dewhisna/TB6600StepperDriver/README.md

# TB6600StepperDriver

This repository contains custom TB6600 Stepper Motor Driver Designs.  It specifically targets retrofit replacement designs for the common HY-DIV268N module.
