dewhisna/TB6600StepperDriver/DEW_TB6600-V1/README.md

# Dewtronics TB6600 Stepper Driver Board V1 (DEW_TB6600-V1)

A much improved drop-in replacement for the common TB6600/HY-DIV268N Stepper Driver Module.

This board can be ordered from [https://www.oshpark.com/shared_projects/tKN4X7AL](https://www.oshpark.com/shared_projects/tKN4X7AL).

A customizable 3D Printable case can be found at: [https://www.thingiverse.com/thing:1917535](https://www.thingiverse.com/thing:1917535).
