dewhisna/TB6600StepperDriver/DEW_TB6600-V1/preview/DEW_TB6600-V1-00b-BoardBottom.png

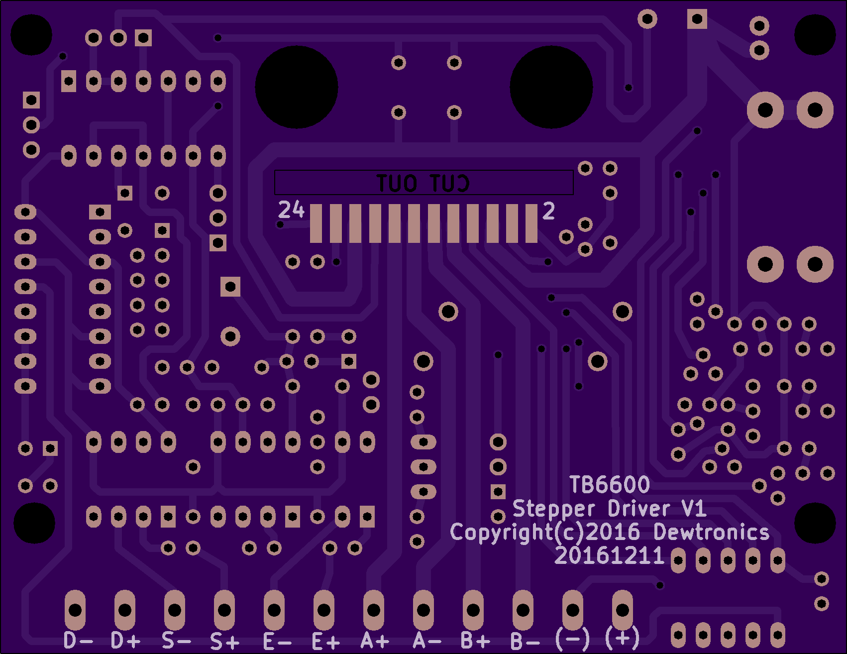
DEW_TB6600-V1/preview/DEW_TB6600-V1-00b-BoardBottom.png
