dewhisna/TB6600StepperDriver/DEW_TB6600-V1/preview/DEW_TB6600-V1-03-Drills.png

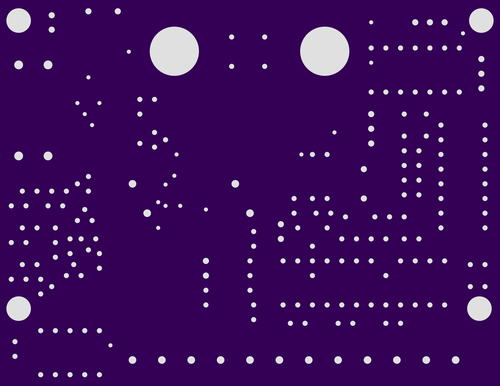
DEW_TB6600-V1/preview/DEW_TB6600-V1-03-Drills.png
