dewhisna/TB6600StepperDriver/DEW_TB6600-V1/preview/DEW_TB6600-V1-05-BottomLayer.png

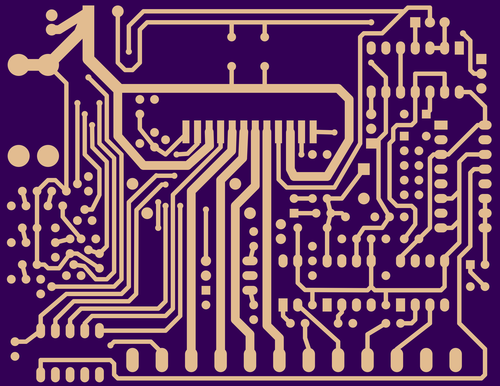
DEW_TB6600-V1/preview/DEW_TB6600-V1-05-BottomLayer.png
