dewhisna/TB6600StepperDriver/DEW_TB6600-V1/preview/DEW_TB6600-V1-09-BottomSilkScreen.png

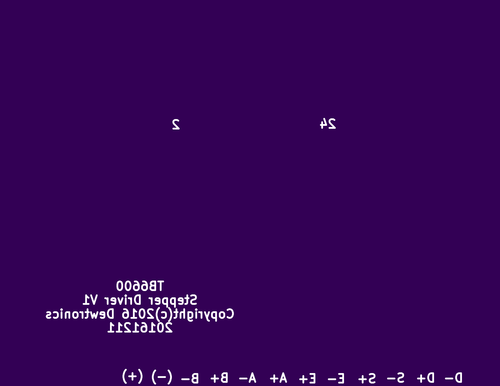
DEW_TB6600-V1/preview/DEW_TB6600-V1-09-BottomSilkScreen.png
