dewhisna/TB6600StepperDriver/DEW_TB6600-V1/DEW_TB6600-V1.pdf

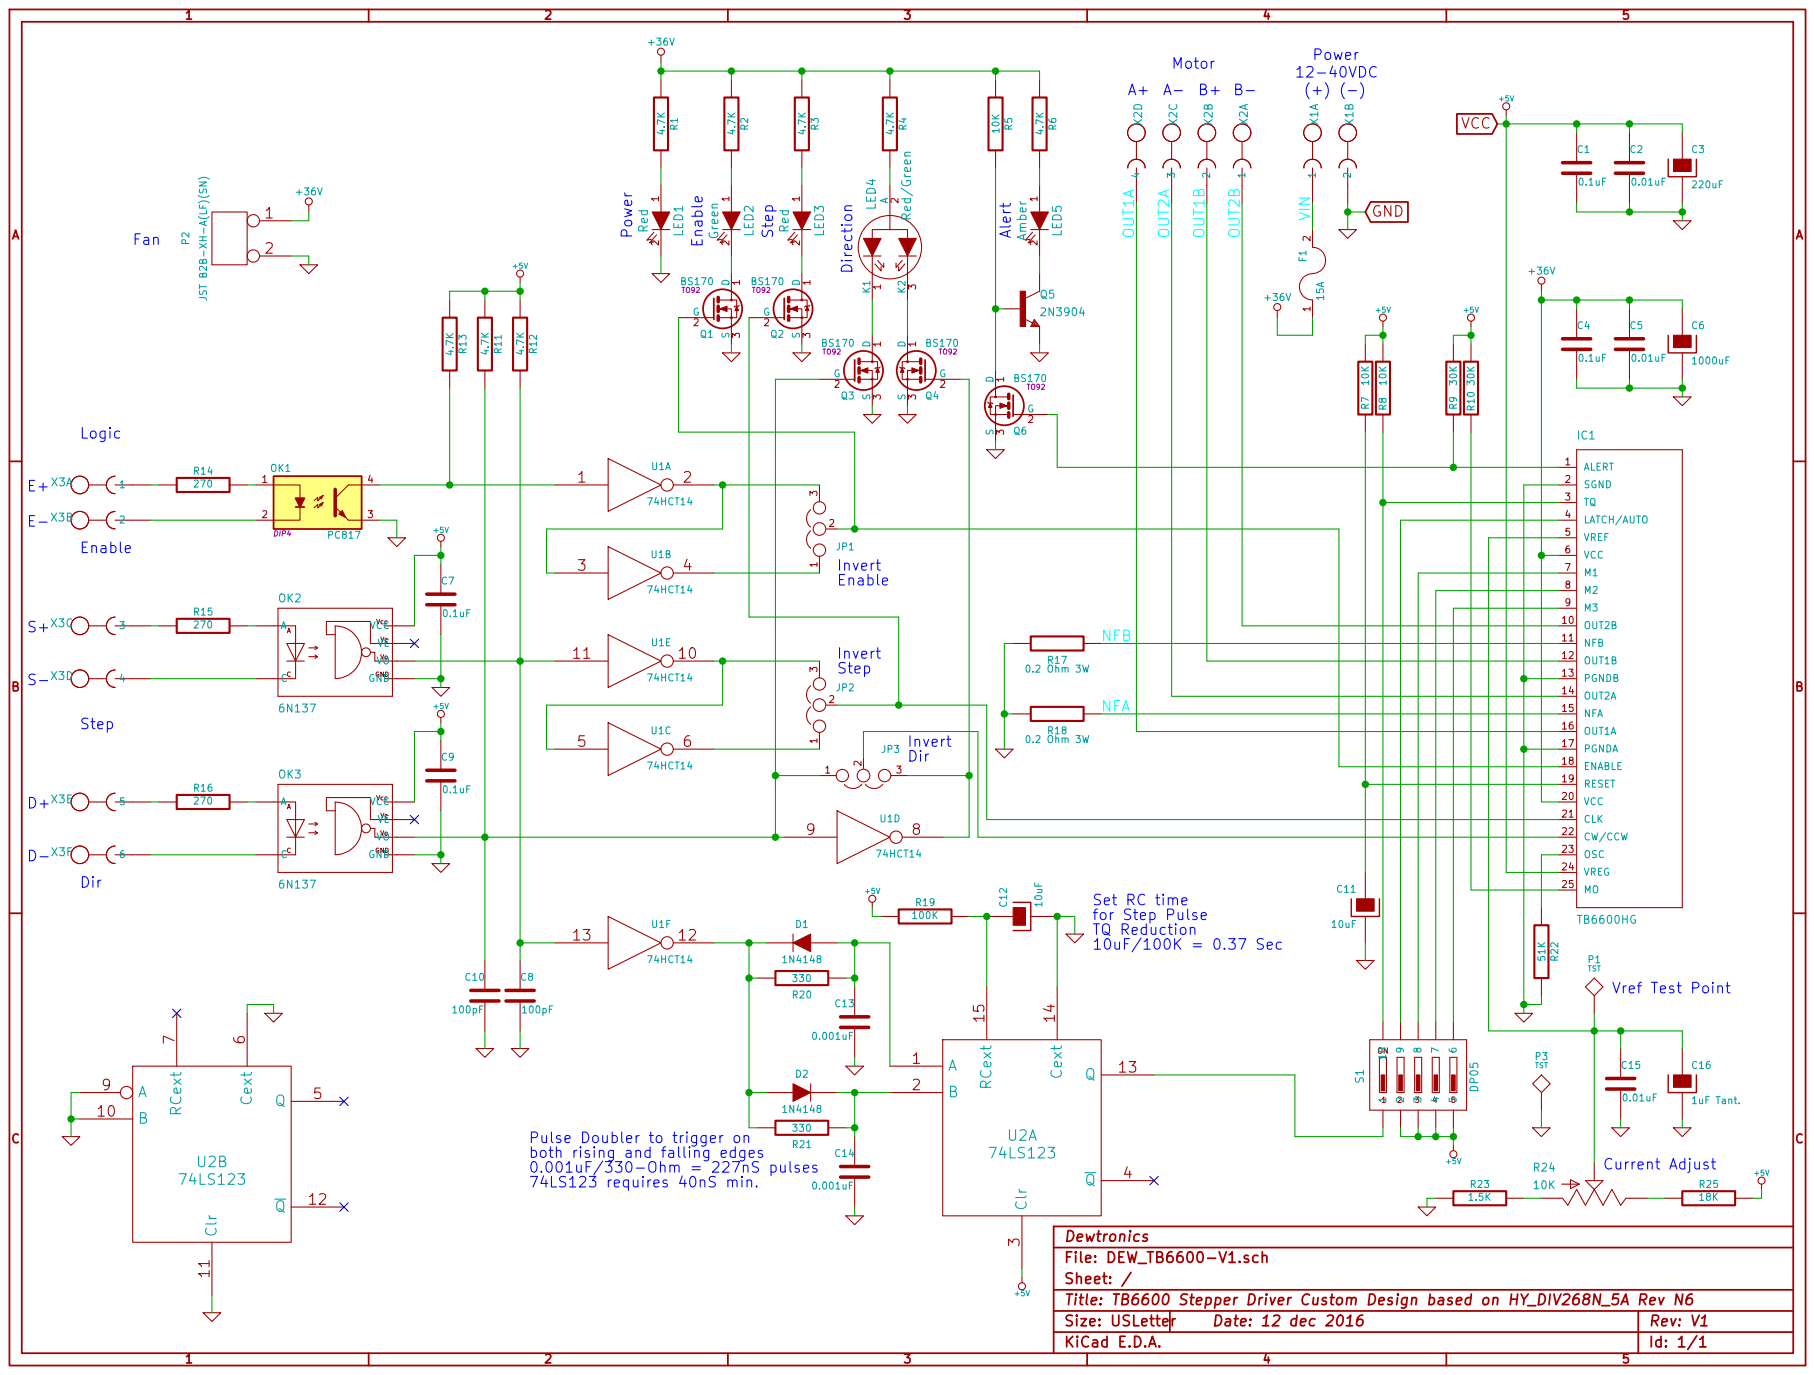
[picture p9: page 1]

4 X2D R9 30K Power Enable Step Direction Alert Motor Logic

2 P2 JST B2B-XH-A(LF)(SN) Fan

1N4148 Pulse Doubler to trigger on

both rising and falling edges
0.001uF/330-Ohm = 227nS pulses
74LS123 requires 40nS min.

Title: TB6600 Stepper Driver Custom Design based on HY_DIV268N_5A Rev N6
