dewhisna/TB6600StepperDriver/DEW_TB6600-V1/DEW_TB6600-V1.kicad_pcb

## KiCad design DEW_TB6600-V1/DEW_TB6600-V1.kicad_pcb (2016-12-12)

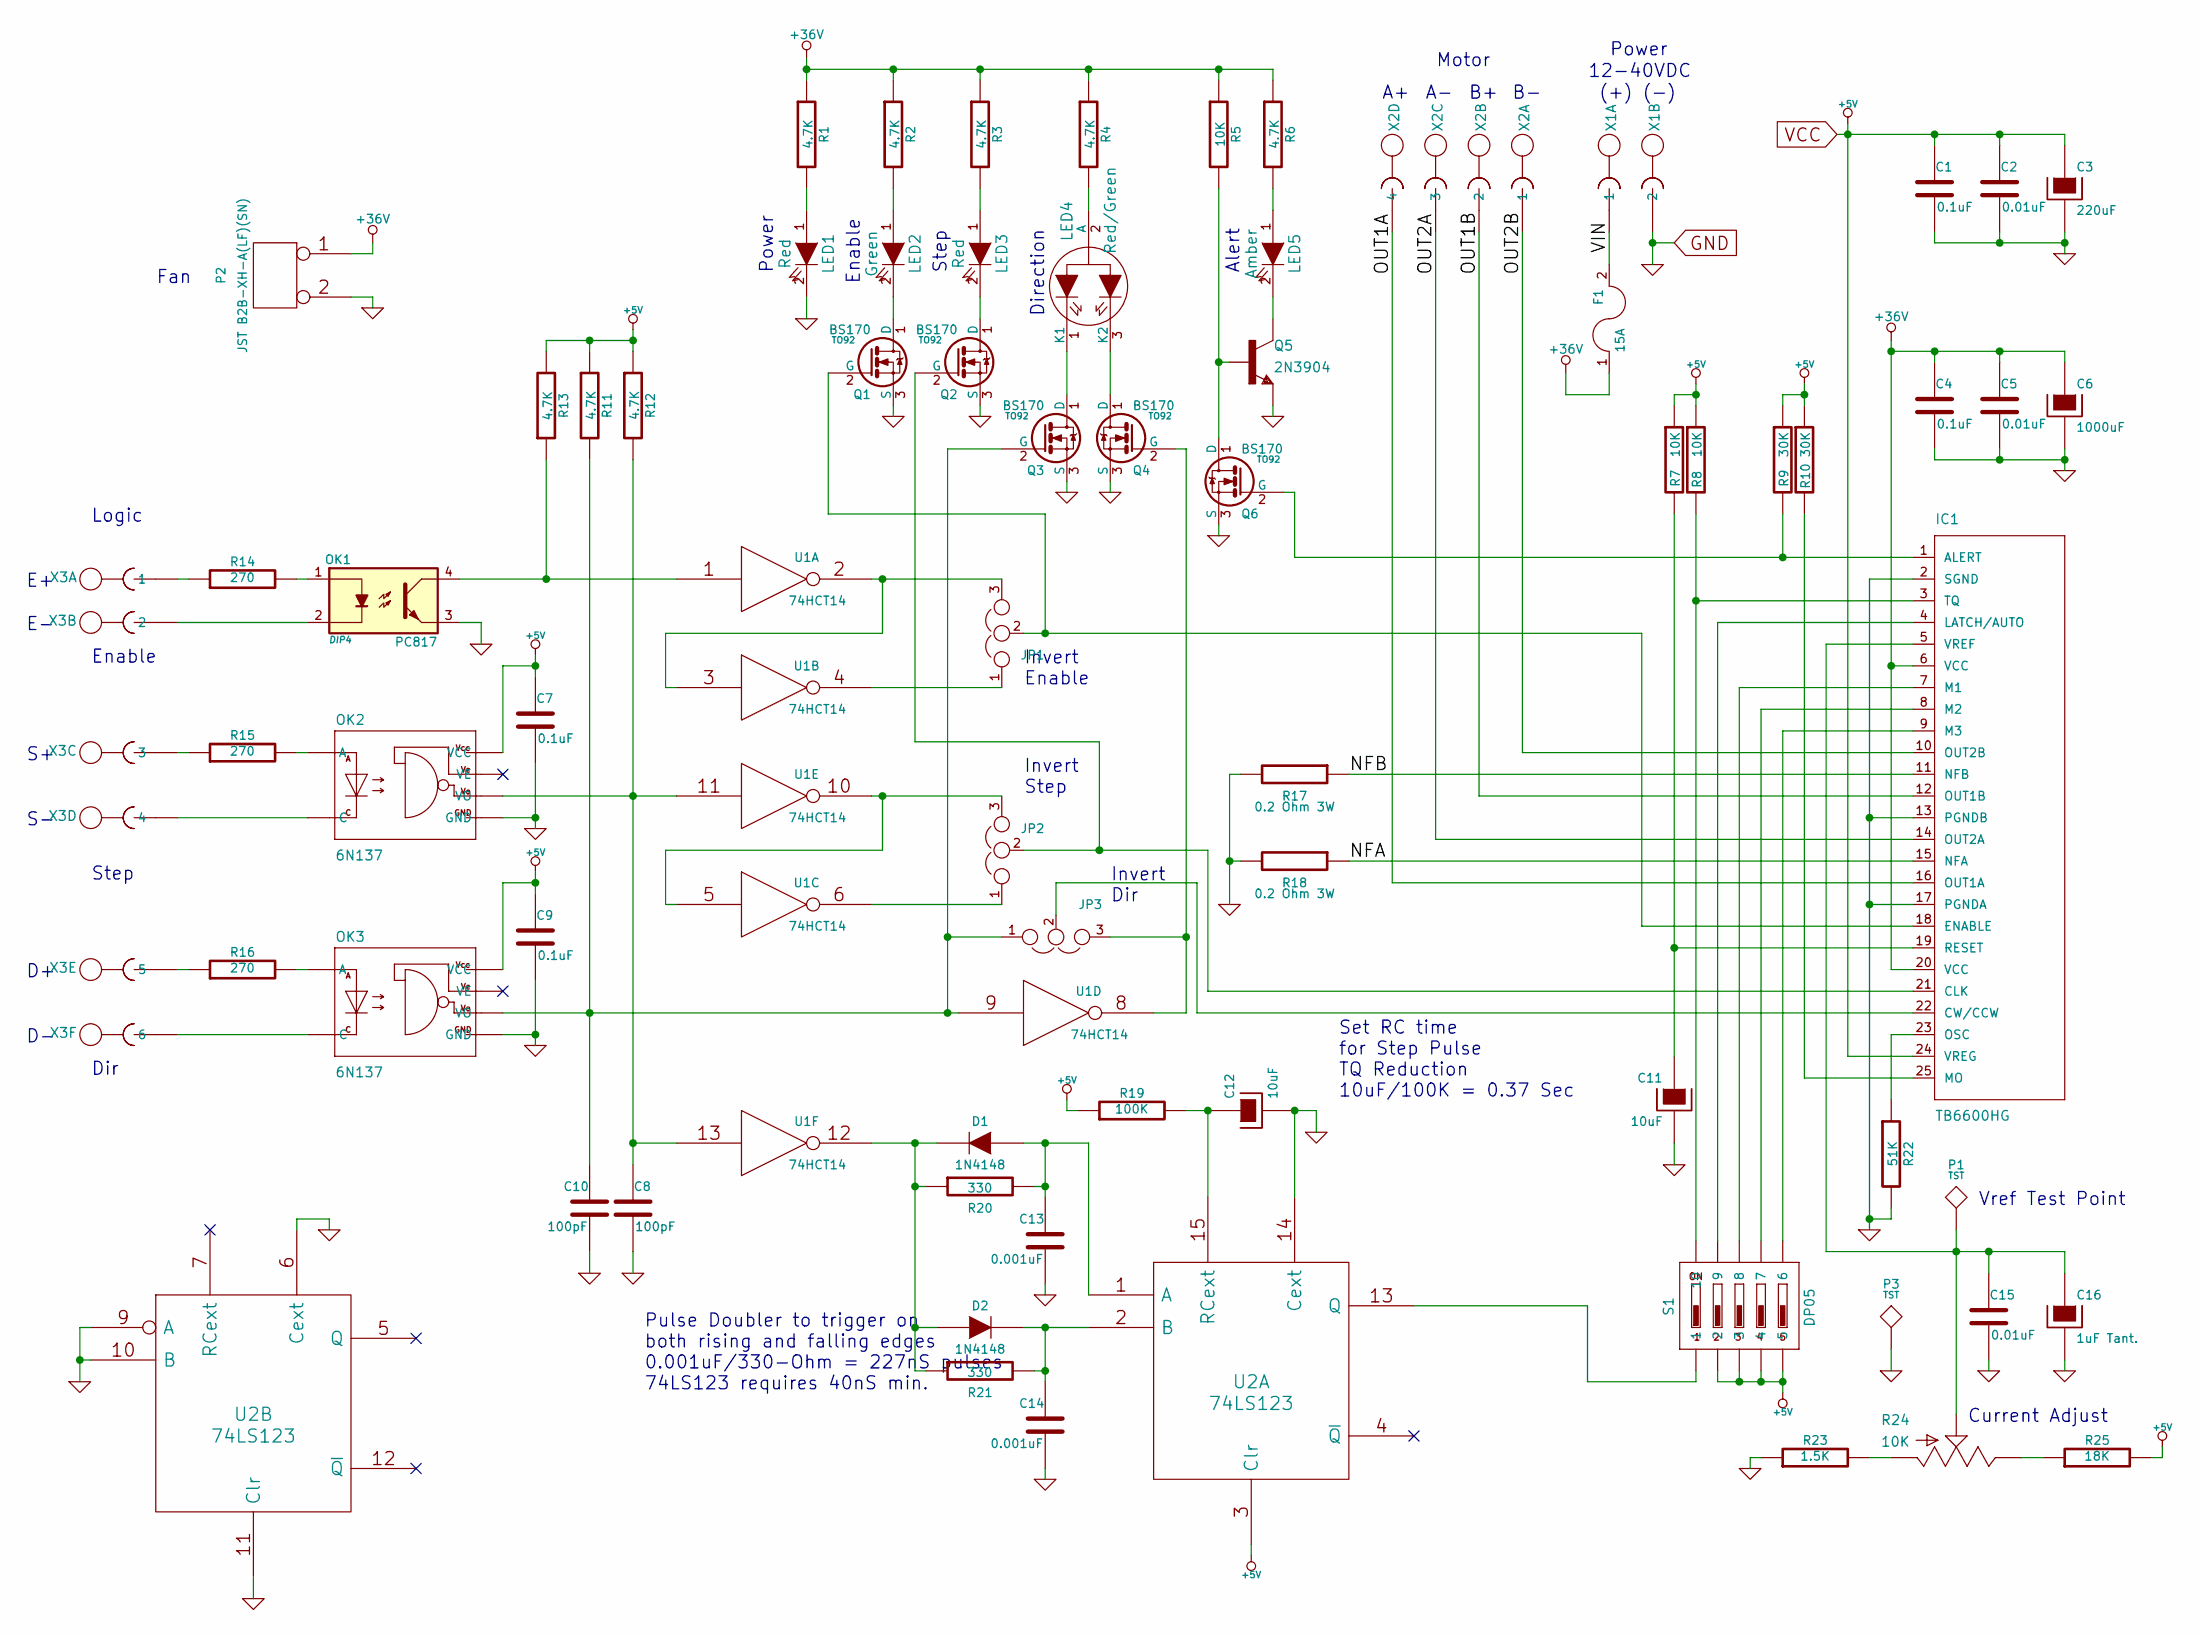
[picture p10: schematic DEW_TB6600-V1.sch, TB6600 Stepper Driver Custom Design based on HY_DIV268N_5A …]

Parts:
C1, C4, C7, C9: 0.1uF
C2, C5, C15: 0.01uF
C3: 220uF
C6: 1000uF
C8, C10: 100pF
C11, C12: 10uF
C13, C14: 0.001uF
C16: 1uF Tant.
D1, D2: 1N4148
F1: 15A
IC1: TB6600HG
JP1, JP2, JP3: JUMPER3
LED1, LED3: Red
LED2: Green
LED4: Red/Green
LED5: Amber
OK1: PC817; DIP4
OK2, OK3: 6N137
P1, P3: TST
P2: JST B2B-XH-A(LF)(SN)
Q1, Q2, Q3, Q4, Q6: BS170; TO92
Q5: 2N3904
R1, R2, R3, R4, R6, R11, R12, R13: 4.7K
R5, R7, R8: 10K
R9, R10: 30K
R14, R15, R16: 270
R17, R18: 0.2 Ohm 3W
R19: 100K
R20, R21: 330
R22: 51K
R23: 1.5K
R24: 10K
R25: 18K
S1: DP05
U1: 74HCT14
U2: 74LS123
X1: MSTBV2
X2: MSTBV4
X3: MSTBV6

Connections:
+36V: C4.1, C5.1, C6.1, F1.1, IC1.6 (VCC), IC1.20 (VCC), P2.1, R1.1, R2.1, R3.1, R4.1, R5.1, R6.1
/NFA: IC1.15 (NFA), R18.1
/NFB: IC1.11 (NFB), R17.1
/OUT1A: IC1.16 (OUT1A), X2.4
/OUT1B: IC1.12 (OUT1B), X2.2
/OUT2A: IC1.14 (OUT2A), X2.3
/OUT2B: IC1.10 (OUT2B), X2.1
/VIN: F1.2, X1.1
GND: C1.2, C2.2, C3.2, C4.2, C5.2, C6.2, C7.2, C8.2, C9.2, C10.2, C11.2, C12.2, C13.2, C14.2, C15.2, C16.2, IC1.2 (SGND), IC1.13 (PGNDB), IC1.17 (PGNDA), LED1.2 (K), OK1.3, OK2.5 (GND), OK3.5 (GND), P2.2 (PM), P3.1, Q1.3 (S), Q2.3 (S), Q3.3 (S), Q4.3 (S), Q5.3 (E), Q6.3 (S), R17.2, R18.2, R22.2, R23.1, U1.7 (GND), U2.6 (Cext), U2.8 (GND), U2.9 (A), U2.10 (B), U2.11 (Clr), U2.14 (Cext), X1.2
unnamed: LED5.1 (A), R6.2
unnamed: LED3.1 (A), R3.2
unnamed: LED2.1 (A), R2.2
unnamed: LED1.1 (A), R1.2
unnamed: R16.1, X3.5
unnamed: OK1.1, R14.2
unnamed: R15.1, X3.3
unnamed: OK2.2 (A), R15.2
unnamed: OK2.3 (C), X3.4
unnamed: OK3.2 (A), R16.2
unnamed: OK3.3 (C), X3.6
unnamed: R14.1, X3.1
unnamed: OK1.2, X3.2
unnamed: IC1.8 (M2), S1.7
unnamed: IC1.7 (M1), S1.8
unnamed: IC1.4 (LATCH/AUTO), S1.9
unnamed: Q5.2 (B), Q6.1 (D), R5.2
unnamed: LED5.2 (K), Q5.1 (C)
unnamed: LED3.2 (K), Q2.1 (D)
unnamed: LED2.2 (K), Q1.1 (D)
unnamed: IC1.22 (CW/CCW), JP3.2
unnamed: JP2.1, U1.6
unnamed: JP2.3, U1.5, U1.10
unnamed: JP1.1, U1.4
unnamed: R23.2, R24.1 (A)
unnamed: R24.3 (E), R25.1
unnamed: OK1.4, R13.1, U1.1
unnamed: C15.1, C16.1, IC1.5 (VREF), P1.1, R24.2 (S)
unnamed: IC1.18 (ENABLE), JP1.2, Q1.2 (G)
unnamed: JP1.3, U1.2, U1.3
unnamed: IC1.9 (M3), S1.6
unnamed: C13.1, D1.1 (A), R20.2, U2.1 (A)
unnamed: C14.1, D2.2 (K), R21.2, U2.2 (B)
unnamed: D1.2 (K), D2.1 (A), R20.1, R21.1, U1.12
unnamed: IC1.25 (MO), R10.2
unnamed: C12.1, R19.2, U2.15 (RCext)
unnamed: S1.1, U2.13 (Q)
unnamed: IC1.3 (TQ), R8.2, S1.10
unnamed: C8.1, OK2.6 (VO), R12.2, U1.11, U1.13
unnamed: IC1.1 (ALERT), Q6.2 (G), R9.2
unnamed: C10.1, JP3.1, OK3.6 (VO), Q3.2 (G), R11.2, U1.9
unnamed: IC1.21 (CLK), JP2.2, Q2.2 (G)
unnamed: LED4.2 (A), R4.2
unnamed: LED4.3 (K2), Q4.1 (D)
unnamed: LED4.1 (K1), Q3.1 (D)
unnamed: JP3.3, Q4.2 (G), U1.8
unnamed: IC1.23 (OSC), R22.1
unnamed: C11.1, IC1.19 (RESET), R7.2
VCC: C1.1, C2.1, C3.1, C7.1, C9.1, IC1.24 (VREG), OK2.8 (VCC), OK3.8 (VCC), R7.1, R8.1, R9.1, R10.1, R11.1, R12.1, R13.2, R19.1, R25.2, S1.2, S1.3, S1.4, S1.5, U1.14 (VCC), U2.3 (Clr), U2.16 (VCC)

Notes on the sheet:
Enable
Step
Dir
Power
Direction
Alert
Motor
Logic
Set RC time for Step Pulse TQ Reduction 10uF/100K = 0.37 Sec
Pulse Doubler to trigger on both rising and falling edges 0.001uF/330-Ohm = 227nS pulses 74LS123 requires 40nS min.
Current Adjust
12-40VDC
(+)
(-)
Invert Enable
Vref Test Point
Fan
Invert Step
Invert Dir

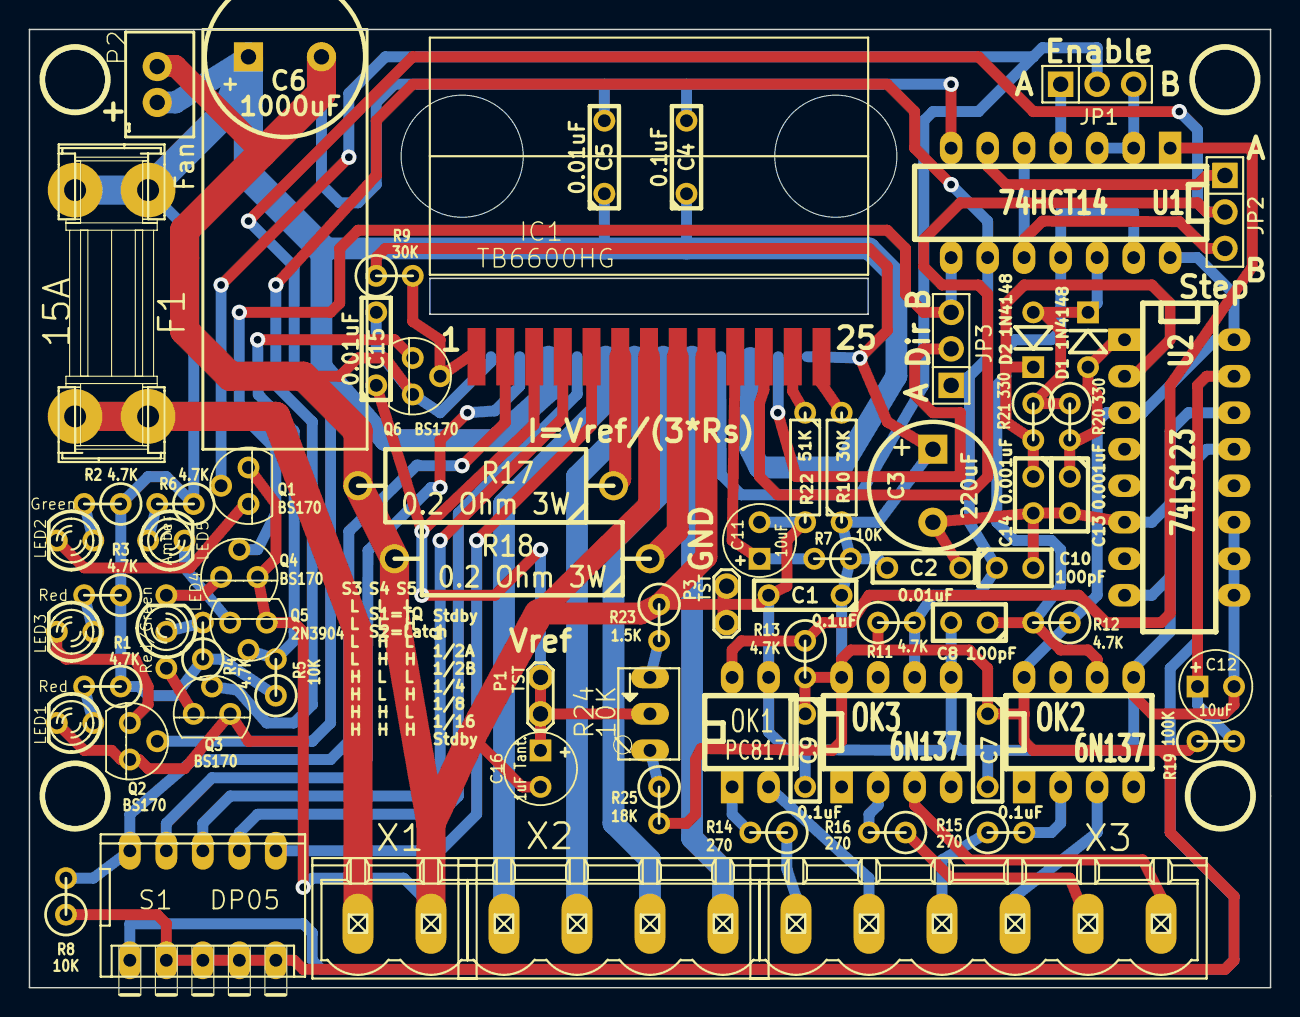
[picture p11: board DEW_TB6600-V1.kicad_pcb from above]

Board: 2 copper layers, 86.4 x 66.7 mm, 75 parts (0 on the bottom side), 58 nets.

Other parts of the board:
1PIN, 1PIN#2, 1PIN#3, 1PIN#4: P***; 1pin
