dewhisna/TB6600StepperDriver/(notices)

Notices in the files:
DEW_TB6600-V1/DEW_TB6600-V1.kicad_pcb:
Copyright(c)2016 Dewtronics
